brandonbunt/LHCM/Internal Lab Procedure/Internal Lab Procedure.docx

10 M 11/8/23

Lab notes/test procedure

1. Objective: Test copper, determine k value
2. Fill bucket with ice by loading ice in from ice machine in the front of the room
  a. Had to repurpose a bucket in the lab that had thermocouples, etc.
  b. (Note: Still need new cooler)
  c. Make sure there is room to submerge pump
    i. If not, use secondary bucket to remove some ice
  d. Make sure temperatures are accurate to what they should be
3. Turn Water pump on
  a. Make sure nothing spills
    i. If water spills, check outlet. Is it in the ice bath?
    ii. Consider: changing the paper to silicone/ water resistant material
  b. Check temps with handheld thermometer, are they what they should be?
    i. Ice bath temp should not exceed 2C
    ii. Outlet temp should be as close as possible to ice bath temp. (about <=1C)
  c. Listen to pump, is there enough water in the ice bath?
4. Build the heat tower
  a. Stack from bottom to top modules.
    i. Bottom-most module has holes on the upper side of the module.
      1. Add thermal paste to top and bottom of sample module/ where needed on other modules.
      2. Note: it helps to insert thermocouples to sample module before adding thermal paste. (see 4b)
    ii. Sample module.
    iii. Above sample module has holes on the bottom side of module.
    iv. Heater module
  b. Add thermocouples (currently, the chips are oriented horizontally on desk)
    i. The rightmost chip corresponds to the uppermost hole on the tower.
    ii. As the thermocouples descend on the tower, they correlate to the chips from right to left.
  c. Check if the heater is inserted to the tower. If not, insert it to the top module.
5. Turn on controller
6. Make sure the Arduino is connected to the computer and serial studio is running
7. Turn on heater
8. During experiment
  a. Periodically check and note the power, ice bath temperature, outlet temperature, and thermocouple temps.
  b. Periodically check to make sure the water pump is still running.

Notes from today’s copper experiment:

- Thermocouple A is not producing data and Thermocouple H appears cooler than Thermocouple G (physically impossible, H is closer to heater)
- Air pocket added to heater module seems effective!! At 95C, the top module is not too hot to touch as opposed to the previous module
