brandonbunt/LHCM/Component Documentation/PowerMeterUserManual.pdf

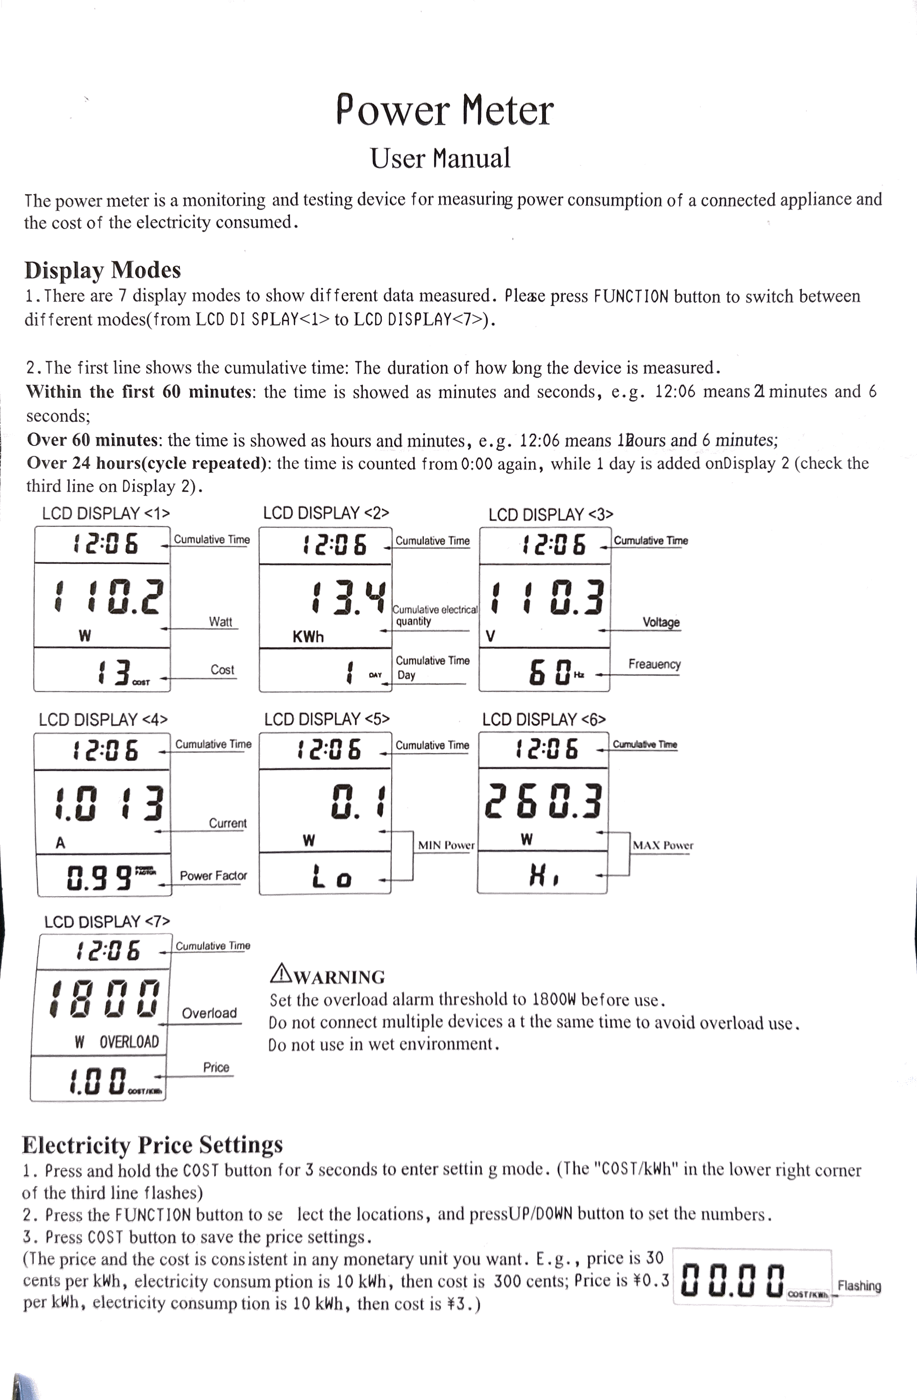
[picture p8: page 1]
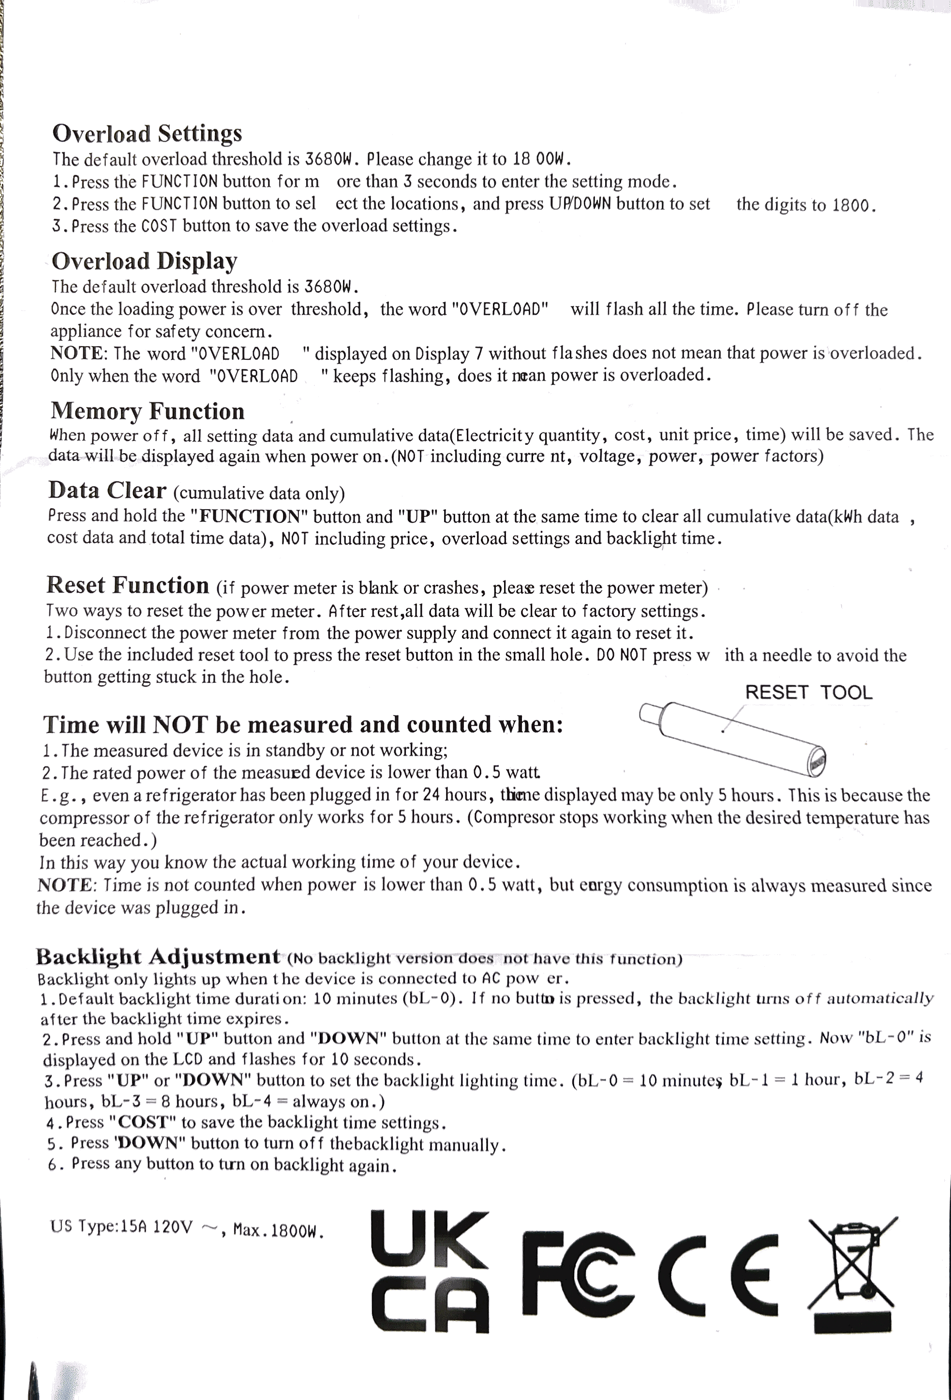
[picture p9: page 2]
