brandonbunt/LHCM/Copper 110 Tests/1108.csv

RX Date/Time | Millis(field 1) | ThermA(field 2) | ThermB(field 3) | ThermC(field 4) | ThermD(field 5) | ThermE(field 6) | ThermF(field 7) | ThermG(field 8) | ThermH(field 9)
2023/11/08/ 11:38:47::886 | 3134 | 15.19 | 16.50 | 16.37 | 18.12 | 17.62 | 18.56 | 18.69 | 20.19
2023/11/08/ 11:38:48::068 | 3246 | 14.56 | 16.50 | 16.37 | 18.44 | 17.62 | 18.56 | 18.69 | 20.19
2023/11/08/ 11:38:48::108 | 3357 | 14.56 | 16.56 | 16.37 | 18.44 | 17.62 | 18.56 | 18.87 | 20.19
2023/11/08/ 11:38:48::218 | 3469 | 14.56 | 16.56 | 16.56 | 18.44 | 17.62 | 18.56 | 18.87 | 20.19
2023/11/08/ 11:38:48::329 | 3580 | 14.88 | 16.56 | 16.56 | 18.44 | 17.62 | 18.56 | 18.87 | 20.19
2023/11/08/ 11:38:48::452 | 3692 | 14.88 | 16.31 | 16.56 | 18.44 | 17.69 | 18.56 | 18.87 | 21.06
2023/11/08/ 11:38:48::554 | 3803 | 14.88 | 16.31 | 16.56 | 18.44 | 17.69 | 18.56 | 18.87 | 21.06
2023/11/08/ 11:38:48::665 | 3914 | 14.75 | 16.31 | 16.56 | 18.37 | 17.69 | 18.56 | 18.87 | 21.06
2023/11/08/ 11:38:48::776 | 4026 | 14.75 | 16.56 | 16.56 | 18.37 | 17.69 | 18.75 | 18.69 | 21.06
2023/11/08/ 11:38:48::887 | 4137 | 14.75 | 16.56 | 16.56 | 18.37 | 17.69 | 18.75 | 18.69 | 21.06
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
