brandonbunt/LHCM/(commit log)

2023-11-20 Copper Data from Nov 8th morning and New Procedure
    [1108.csv]
2023-12-17 Power Meter User Manual
    Created new directory for component manuals and documentation. Renamed procedure document.
2024-01-12 Weekly Update S24 W1 Fri
    Reorganized file structure, added edited and improved internal procedure. Removed irrelevant drafts.
    [1108.csv]
2024-05-03 Differential Thermocouple Arduino
    Arduino code that enables differential thermocouple measurement as microvolt(uv). Requires external terminal(i.e. PuTTY) to record data.
